wtg/Shuttle-Tracker-Node/CAD/Case/STL for print/case_6.stl

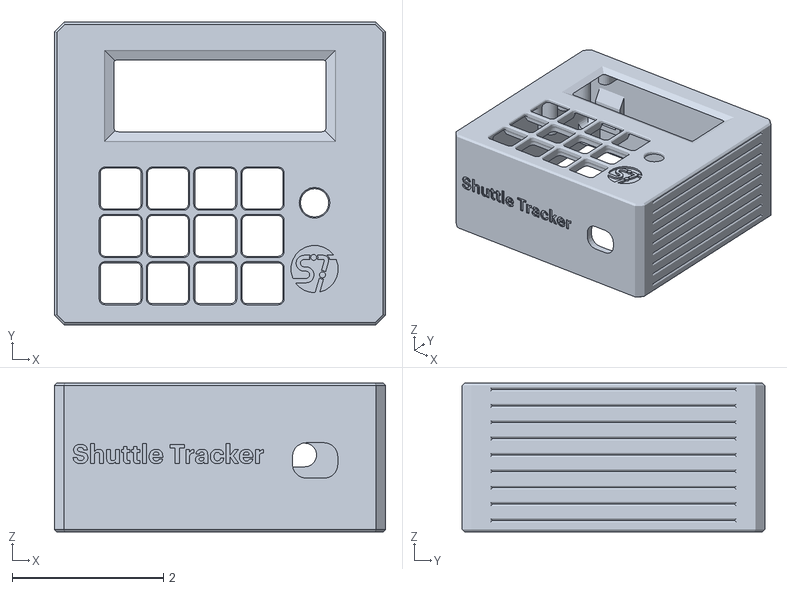
[picture p3: CAD file, 2023-11-10]
CAD/Case/STL for print/case_6.stl
4.38 x 4.00 x 1.97
