wtg/Shuttle-Tracker-Node/CAD/PCB/Footprints, Models, & Symbols/PEC11R-4215F-S0024/PEC11R-4215F-S0024.step

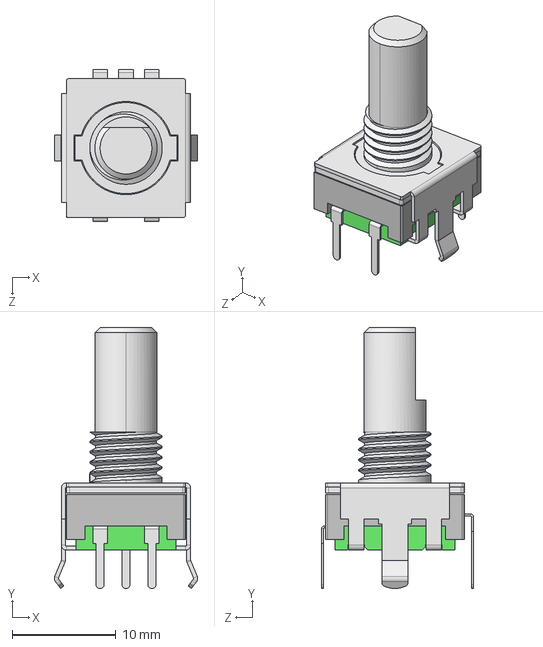
[picture p4: CAD file, 2023-01-28]
CAD/PCB/Footprints, Models, & Symbols/PEC11R-4215F-S0024/PEC11R-4215F-S0024.step
13.9 x 25.2 x 14.7 mm
