wtg/Shuttle-Tracker-Node/CAD/PCB/Shuttle Tracker Node.step

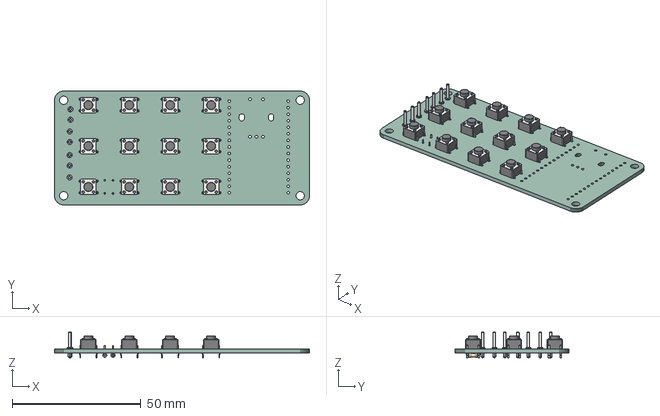
[picture p5: CAD file, 2023-02-28]
CAD/PCB/Shuttle Tracker Node.step
98.9 x 44.1 x 10.0 mm
PCB
