wtg/Shuttle-Tracker-Node/CAD/Case/EC11B-Vert-15F-green.step

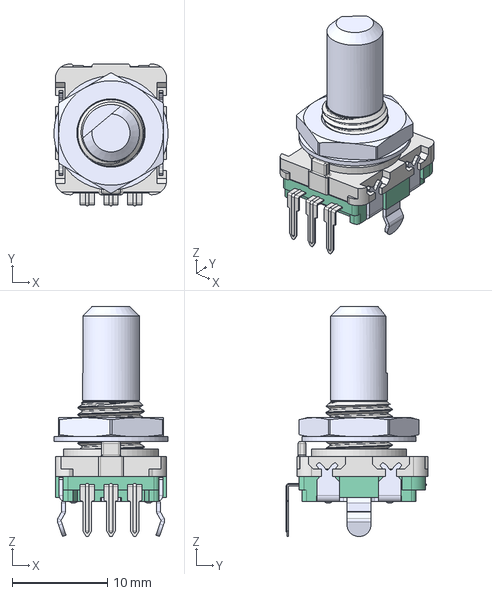
[picture p6: CAD file, 2023-02-28]
CAD/Case/EC11B-Vert-15F-green.step
12.0 x 14.9 x 24.2 mm
