wtg/Shuttle-Tracker-Node/CAD/Case/91294A128_Black-Oxide Alloy Steel Hex Drive Flat Head Screw.STEP

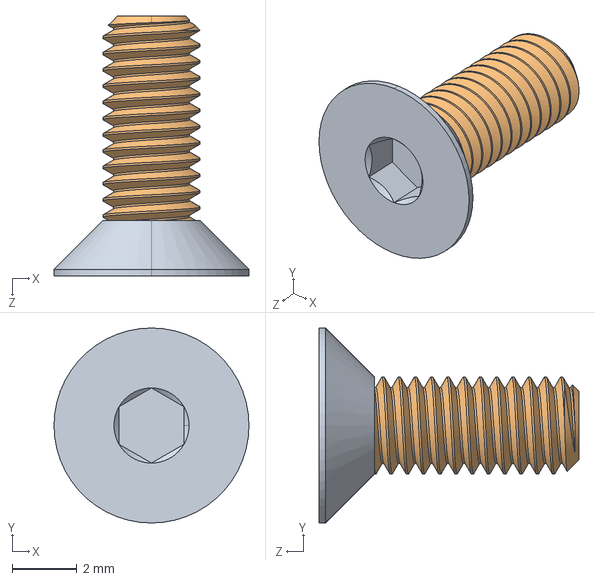
[picture p7: CAD file, 2023-03-14]
CAD/Case/91294A128_Black-Oxide Alloy Steel Hex Drive Flat Head Screw.STEP
6.00 x 6.00 x 8.00 mm
