wtg/Shuttle-Tracker-Node/CAD/Case/Old Models/encoder.STEP

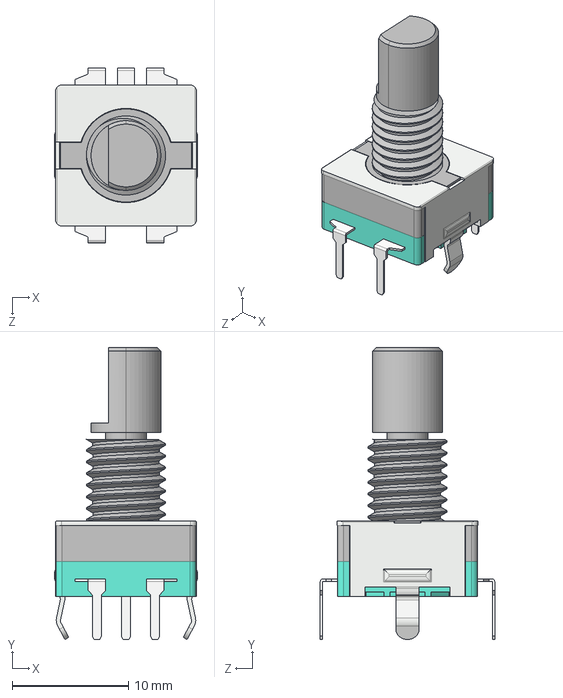
[picture p8: CAD file, 2023-02-07, an earlier design]
CAD/Case/Old Models/encoder.STEP
12.3 x 25.1 x 15.0 mm
