wtg/Shuttle-Tracker-Node/CAD/Case/Old Models/Omron 12x12 button.stp

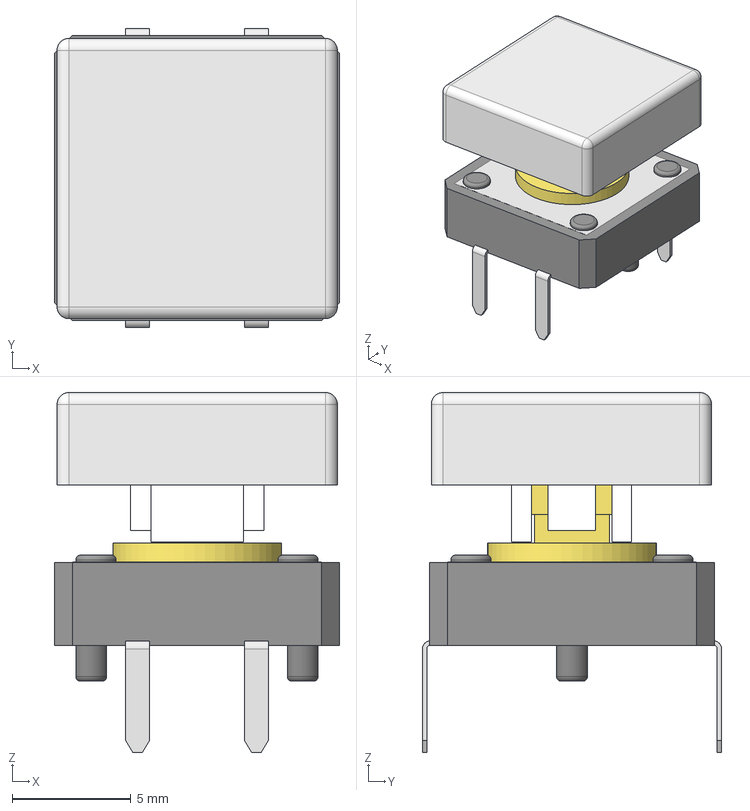
[picture p9: CAD file, 2023-02-07, an earlier design]
CAD/Case/Old Models/Omron 12x12 button.stp
12.0 x 12.6 x 15.2 mm
Buton-1212_capac-intermediar
Buton-1212_capac
Buton-1212_Baza
