wtg/Shuttle-Tracker-Node/(list of files, cad)

Other CAD files:
CAD/Case/STL for print/case_final_no_logo.stl
CAD/Case/STL for print/case_final_with_logo.stl
CAD/Case/16pin_header__.prt
CAD/Case/B3F-switch-projected.prt
CAD/Case/BF32-1010.prt
CAD/Case/NONE131.prt
CAD/Case/NONE194.prt
CAD/Case/NONE44.prt
CAD/Case/Old Models/AMS1173.3V.prt
CAD/Case/Old Models/AMS1173.3V311007.prt
CAD/Case/Old Models/B3F-switch-projected.prt
CAD/Case/Old Models/B3F-switch.prt
CAD/Case/Old Models/Buton-1212_Baza.prt
CAD/Case/Old Models/Buton-1212_capac-intermediar.prt
CAD/Case/Old Models/Buton-1212_capac.prt
CAD/Case/Old Models/Cap_0603.prt
CAD/Case/Old Models/Cap_0603311019.prt
CAD/Case/Old Models/Cap_Tam_106.prt
CAD/Case/Old Models/Cap_Tam_106311011.prt
CAD/Case/Old Models/Cap_Tam_106C.prt
CAD/Case/Old Models/Cap_Tam_106C311012.prt
CAD/Case/Old Models/Diodo_K24.prt
CAD/Case/Old Models/Diodo_K24311010.prt
CAD/Case/Old Models/LCD.prt
CAD/Case/Old Models/Led_red_0603.prt
CAD/Case/Old Models/Led_red_0603311014.prt
CAD/Case/Old Models/MicroUSB.prt
CAD/Case/Old Models/MicroUSB311005.prt
CAD/Case/Old Models/Push_Bottom.prt
CAD/Case/Old Models/Push_Bottom311009.prt
CAD/Case/Old Models/Res_102.prt
CAD/Case/Old Models/Res_102311015.prt
CAD/Case/Old Models/Res_123.prt
CAD/Case/Old Models/Res_123311017.prt
CAD/Case/Old Models/Res_471.prt
CAD/Case/Old Models/Res_471311016.prt
CAD/Case/Old Models/Res_512.prt
CAD/Case/Old Models/Res_512311018.prt
CAD/Case/Old Models/Transistor_smd.prt
CAD/Case/Old Models/Transistor_smd311013.prt
CAD/Case/Old Models/b3f-button-large.prt
CAD/Case/Old Models/bar.prt
CAD/Case/Old Models/case-print-1.prt
CAD/Case/Old Models/clamp_idea_1.prt
CAD/Case/Old Models/cp2102.prt
CAD/Case/Old Models/cp2102311008.prt
CAD/Case/Old Models/dial_1.prt
CAD/Case/Old Models/encoder.prt
CAD/Case/Old Models/esp32311006.prt
CAD/Case/Old Models/keycap_2_clip.prt
CAD/Case/Old Models/keycap_2_glue.prt
CAD/Case/Old Models/layout.prt
CAD/Case/Old Models/presentation_bla.prt
CAD/Case/PCB10213.prt
CAD/Case/Pin_D1.0mm_L10.0mm.prt
CAD/Case/Pin_D1.0mm_L10.0mm116.prt
CAD/Case/backlight.prt
CAD/Case/battery-holder.prt
CAD/Case/button_TPU_0.prt
CAD/Case/button_TPU_1.prt
CAD/Case/button_TPU_2.prt
CAD/Case/button_TPU_3.prt
CAD/Case/button_TPU_4.prt
CAD/Case/button_TPU_5.prt
CAD/Case/button_TPU_6.prt
CAD/Case/button_TPU_7.prt
CAD/Case/button_TPU_8.prt
CAD/Case/button_TPU_9.prt
CAD/Case/button_TPU_astrix.prt
CAD/Case/button_TPU_pound.prt
CAD/Case/button_cap_offset/buttonCap0.prt
CAD/Case/button_cap_offset/buttonCap1.prt
CAD/Case/button_cap_offset/buttonCap2.prt
CAD/Case/button_cap_offset/buttonCap3.prt
CAD/Case/button_cap_offset/buttonCap4.prt
CAD/Case/button_cap_offset/buttonCap5.prt
CAD/Case/button_cap_offset/buttonCap6.prt
CAD/Case/button_cap_offset/buttonCap7.prt
CAD/Case/button_cap_offset/buttonCap8.prt
CAD/Case/button_cap_offset/buttonCap9.prt
CAD/Case/button_cap_offset/buttonCapAstrix.prt
CAD/Case/button_cap_offset/buttonCapPound.prt
CAD/Case/case_2.prt
CAD/Case/case_2_back.prt
CAD/Case/case_3.prt
CAD/Case/case_3_back.prt
CAD/Case/case_4.prt
CAD/Case/case_5.prt
CAD/Case/case_5_b.prt
CAD/Case/conductor.prt
CAD/Case/dial_2.prt
CAD/Case/keys.prt
CAD/Case/lcd window.prt
CAD/Case/lcm.prt
CAD/Case/liquid crystal grabcad.prt
CAD/Case/logo.prt
CAD/Case/m3_8_screw.prt
CAD/Case/pcb_board.prt
CAD/Case/pcbboard.prt
CAD/Case/power_button.prt
CAD/Case/protoboard.prt
CAD/Case/rotary_encoder.prt
CAD/Case/smt_resistor101.prt
CAD/Case/smt_resistor222.prt
CAD/PCB/PCB.prt
CAD/PCB/Shuttle Tracker Node.prt
CAD/PCB/case_3_perfboard.prt
