wtg/Shuttle-Tracker-Node/Wiring Diagram.png

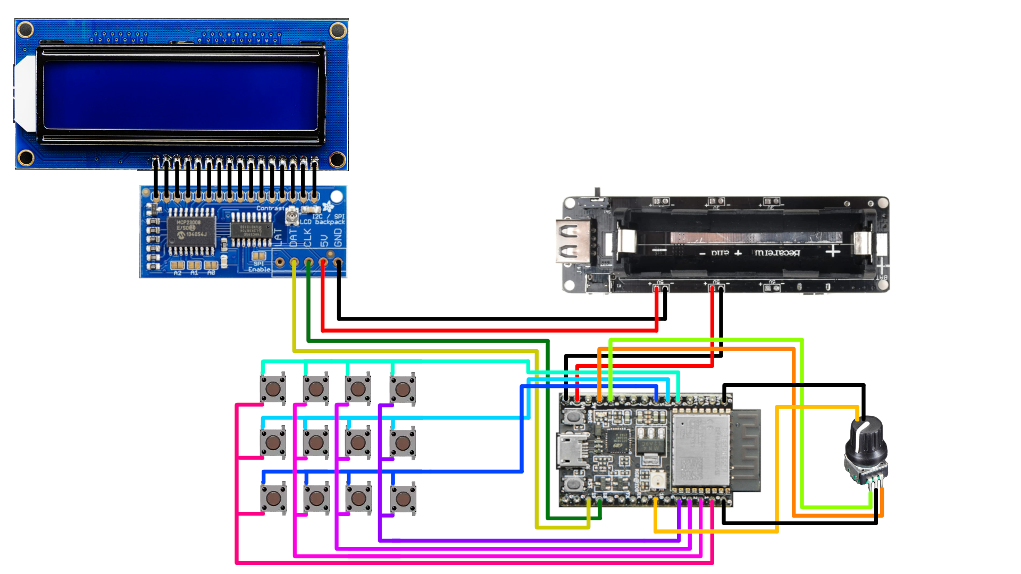
Wiring Diagram.png
