wtg/Shuttle-Tracker-Node/CAD/PCB/Shuttle Tracker Node.kicad_pcb

## KiCad design CAD/PCB/Shuttle Tracker Node.kicad_pcb (2023-03-26)

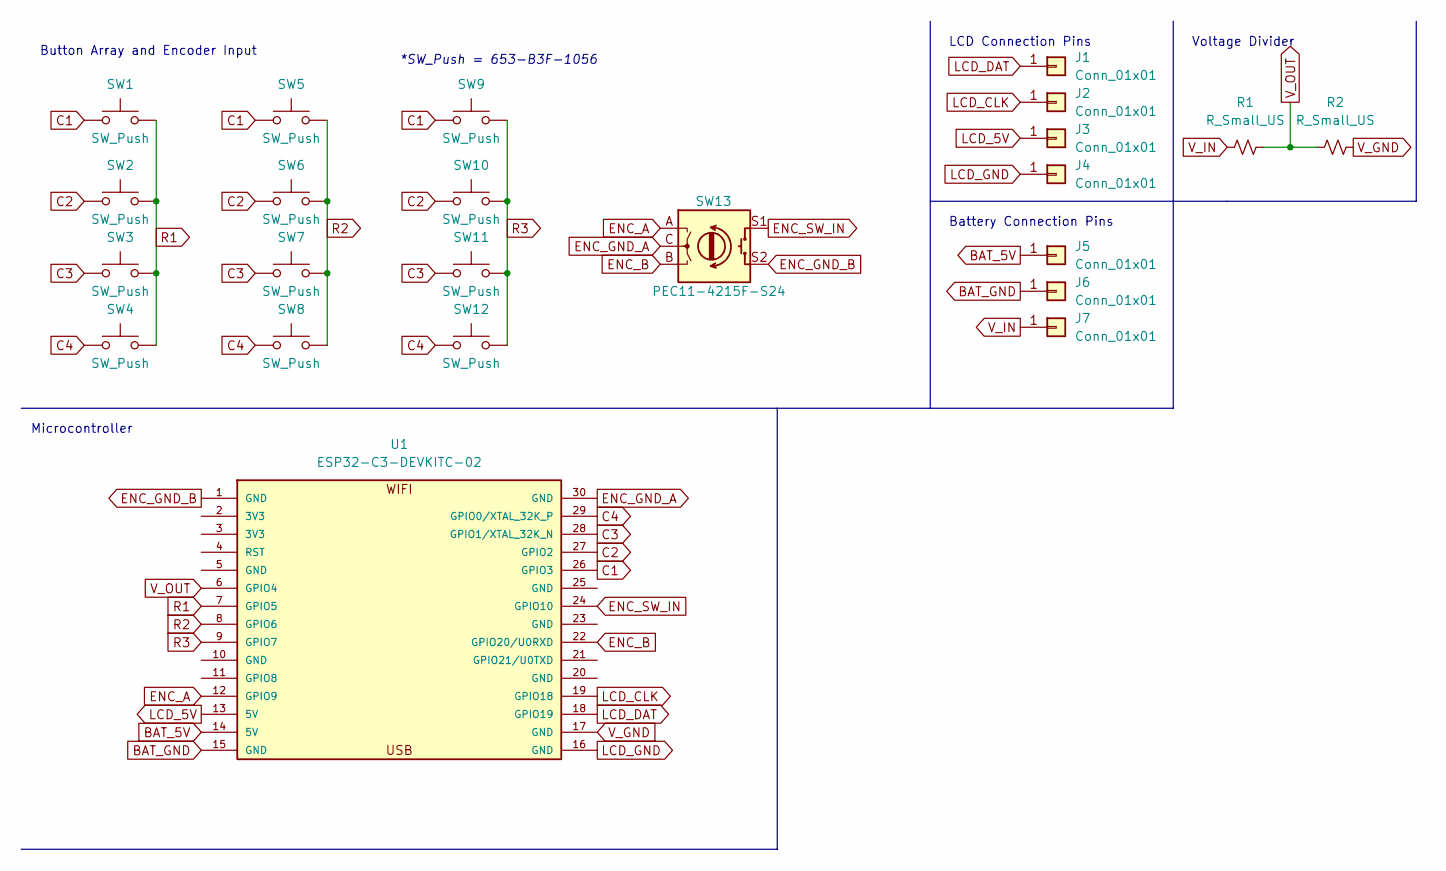
[picture p11: schematic Shuttle Tracker Node.kicad_sch]

Parts:
J1, J2, J3, J4, J5, J6, J7: Conn_01x01; Pin_D1.0mm_L10.0mm
R1, R2: R_Small_US; R_Axial_DIN0204_L3.6mm_D1.6mm_P5.08mm_Horizontal
SW1, SW2, SW3, SW4, SW5, SW6, SW7, SW8, SW9, SW10, SW11, SW12: SW_Push; B3F-1056
SW13: PEC11-4215F-S24; PEC11R-4215F-S0024
U1: ESP32-C3-DEVKITC-02; XCVR_ESP32-C3-DEVKITC-02

Connections:
BAT_5V: J5.1, U1.14 (5V)
BAT_GND: J6.1, U1.15 (GND)
C1: SW1.1, SW5.1, SW9.1, U1.26 (GPIO3)
C2: SW2.1, SW6.1, SW10.1, U1.27 (GPIO2)
C3: SW3.1, SW7.1, SW11.1, U1.28 (GPIO1/XTAL_32K_N)
C4: SW4.1, SW8.1, SW12.1, U1.29 (GPIO0/XTAL_32K_P)
ENC_A: SW13.A, U1.12 (GPIO9)
ENC_B: SW13.B, U1.22 (GPIO20/U0RXD)
ENC_GND_A: SW13.C, U1.30 (GND)
ENC_GND_B: SW13.S2, U1.1 (GND)
ENC_SW_IN: SW13.S1, U1.24 (GPIO10)
LCD_5V: J3.1, U1.13 (5V)
LCD_CLK: J2.1, U1.19 (GPIO18)
LCD_DAT: J1.1, U1.18 (GPIO19)
LCD_GND: J4.1, U1.16 (GND)
R1: SW1.2, SW2.2, SW3.2, SW4.2, U1.7 (GPIO5)
R2: SW5.2, SW6.2, SW7.2, SW8.2, U1.8 (GPIO6)
R3: SW9.2, SW10.2, SW11.2, SW12.2, U1.9 (GPIO7)
V_GND: R2.2, U1.17 (GND)
V_IN: J7.1, R1.1
V_OUT: R1.2, R2.1, U1.6 (GPIO4)

Notes on the sheet:
Microcontroller
*SW_Push = 653-B3F-1056
Voltage Divider
Button Array and Encoder Input
Battery Connection Pins
LCD Connection Pins

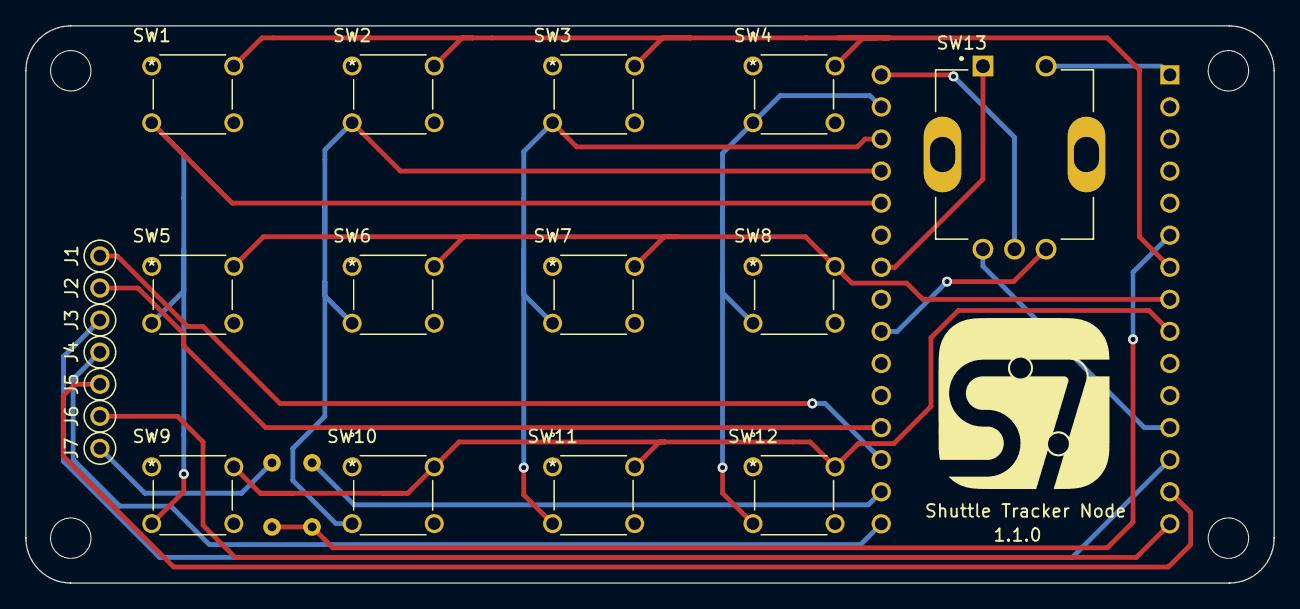
[picture p12: board Shuttle Tracker Node.kicad_pcb from above]

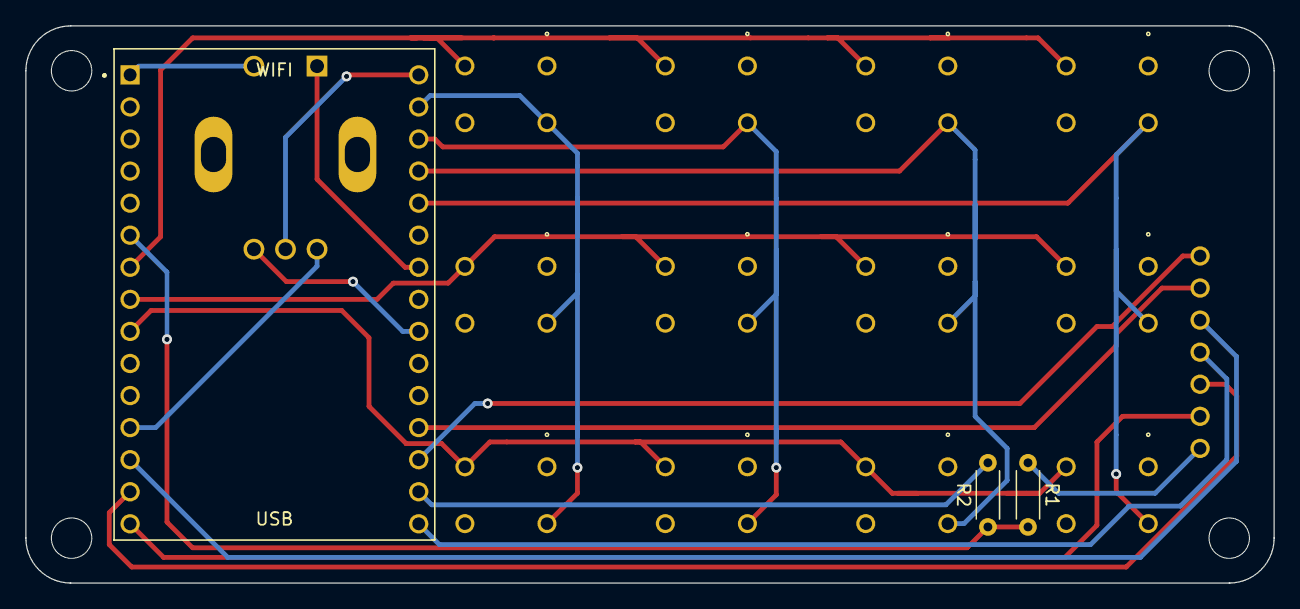
[picture p13: board Shuttle Tracker Node.kicad_pcb from below]

Board: 2 copper layers, 98.9 x 44.1 mm, 23 parts (3 on the bottom side), 21 nets.
