wtg/Shuttle-Tracker-Node/prototyping/Encoder/Encoder.ino

  /*
  This is a mockup of how we can use the encoder to control our display interface
  with the global encoderValue variable. Clockwise turns increase, while Counter
  Clockwise turns decrease encoderValue. At the moment, the amount by which the
  variable changes for each indexed turn on the encoder is not consistent. It will
  change by anywhere from 1 to 4 for each indexed rotation.
  */

  int buttonPin=6;
  int encoderPin1 = 4;
  int encoderPin2 = 5;

  volatile int lastEncoded = 0;
  volatile long encoderValue = 0;
  volatile int lastButton = 0;
  volatile long buttonValue = 0;
  volatile int buttonHeld = 0;

  int lastMSB = 0;
  int lastLSB = 0;

  const int debounce_interval = 200;

  void IRAM_ATTR updateEncoder(){
    int MSB = digitalRead(encoderPin1); //MSB = most significant bit
    int LSB = digitalRead(encoderPin2); //LSB = least significant bit

    static unsigned long last_encoder_time = 0;
    unsigned long interrupt_time = millis();
    if (interrupt_time - last_interrupt_time < debounce_interval ){return;}
    last_encoder_time = interrupt_time;
    int encoded = (MSB << 1) | LSB; //converting the 2 pin value to single number
    int sum  = (lastEncoded << 2) | encoded; //adding it to the previous encoded value


    // Overcounting issue might be solved by adjusting these if statements.
    // It might be that not all clauses are necessary
    if(sum == 0b1101 || sum == 0b0100 || sum == 0b0010 || sum == 0b1011) {
      encoderValue ++;
    }
    if(sum == 0b1110 || sum == 0b0111 || sum == 0b0001 || sum == 0b1000) {
      encoderValue --;
    }

    lastEncoded = encoded; //store this value for next time
  }

  void IRAM_ATTR updateButton(){
    static unsigned long last_interrupt_time = 0;
    unsigned long interrupt_time = millis();

    if (interrupt_time - last_interrupt_time > debounce_interval ){
      int cvalue = digitalRead(buttonPin);
      if(cvalue != lastButton){
        buttonValue++;
        lastButton = cvalue;
        last_interrupt_time = interrupt_time;
      }
    }
  }

  void setup() {

    Serial.begin(115200);
    pinMode(encoderPin1, INPUT_PULLUP);
    pinMode(encoderPin2, INPUT_PULLUP);
    attachInterrupt(encoderPin1, updateEncoder, CHANGE);
    attachInterrupt(encoderPin2, updateEncoder, CHANGE);

    pinMode(buttonPin, INPUT_PULLUP);
    pinMode(7, INPUT_PULLDOWN);
    attachInterrupt(digitalPinToInterrupt(buttonPin), updateButton, CHANGE);

  }

  void loop() {
    Serial.println("------------------");
    Serial.println(encoderValue);
    Serial.println(buttonValue);

    delay(1000);
  }
