wtg/Shuttle-Tracker-Node/prototyping/Display/Display(Adafruit)/Display (Adafruit).ino

#include <Wire.h>
#include <Adafruit_RGBLCDShield.h>
#include <utility/Adafruit_MCP23017.h>

Adafruit_RGBLCDShield lcd = Adafruit_RGBLCDShield();

void setup() {
  // Debugging output
  Serial.begin(9600);
  // set up the LCD's number of columns and rows: 
  lcd.begin(16, 2);

  int time = millis();
  lcd.print("ESP 32");
  time = millis() - time;
  Serial.print("Took "); Serial.print(time); Serial.println(" ms");
  lcd.setBacklight(WHITE);
}

uint8_t i=0;
void loop() {
  // set the cursor to column 0, line 1
  // (note: line 1 is the second row, since counting begins with 0):
  lcd.setCursor(0, 1);
  // print the number of seconds since reset:
  lcd.print(millis()/1000);

  uint8_t buttons = lcd.readButtons();

  if (buttons) {
    lcd.clear();
    lcd.setCursor(0,0);
    if (buttons & BUTTON_UP) {
      lcd.print("UP ");
      lcd.setBacklight(ON);
    }
    if (buttons & BUTTON_DOWN) {
      lcd.print("DOWN ");
      lcd.setBacklight(OFF);
    }
    if (buttons & BUTTON_RIGHT) {
      lcd.print("RIGHT ");
      lcd.setBacklight(ON);
    }
    if (buttons & BUTTON_LEFT) {
      lcd.print("LEFT ");
      lcd.setBacklight(ON);
    }    
}
