wtg/Shuttle-Tracker-Node/prototyping/Firmware_Update(Sketch).ino

#include <WiFi.h>
#include <ESPmDNS.h>
#include <WiFiUdp.h>
#include <ArduinoOTA.h>
#include "Adafruit_LiquidCrystal.h"
#include "BLEDevice.h"
#include "BLEUtils.h"
#include "BLEServer.h"
#include "BLEBeacon.h"

Adafruit_LiquidCrystal lcd(0x20);
BLEAdvertising *pAdvertising;

/*
#This section needs to be moidfied#
const char* ssid = "SpectrumSetup-50";
const char* password = "..........";
*/

void setup() {
  Serial.begin(115200);
  Serial.println("Booting");
  WiFi.mode(WIFI_STA);
  WiFi.begin(ssid, password);
  while (WiFi.waitForConnectResult() != WL_CONNECTED) {
    Serial.println("Connection Failed! Rebooting...");
    delay(5000);
    ESP.restart();
  }

  ArduinoOTA
    .onStart([]() {
      String type;
      if (ArduinoOTA.getCommand() == U_FLASH)
        type = "sketch";
      else // U_SPIFFS
        type = "filesystem";

      // NOTE: if updating SPIFFS this would be the place to unmount SPIFFS using SPIFFS.end()
      Serial.println("Start updating " + type);
    })
    .onEnd([]() {
      Serial.println("\nEnd");
    })
    .onProgress([](unsigned int progress, unsigned int total) {
      Serial.printf("Progress: %u%%\r", (progress / (total / 100)));
    })
    .onError([](ota_error_t error) {
      Serial.printf("Error[%u]: ", error);
      if (error == OTA_AUTH_ERROR) Serial.println("Auth Failed");
      else if (error == OTA_BEGIN_ERROR) Serial.println("Begin Failed");
      else if (error == OTA_CONNECT_ERROR) Serial.println("Connect Failed");
      else if (error == OTA_RECEIVE_ERROR) Serial.println("Receive Failed");
      else if (error == OTA_END_ERROR) Serial.println("End Failed");
    });

  ArduinoOTA.begin();
  
  BLEDevice::init("iBeacon");
  pAdvertising = BLEDevice::getAdvertising();
  
  Serial.println("Ready");
  Serial.print("IP address: ");
  Serial.println(WiFi.localIP());
  
  Serial.begin(115200);

  Wire.begin(4, 5);
  if (!lcd.begin(16, 2)) {
    Serial.println("Could not init backpack. Check wiring.");
    while(1);
  }
  lcd.print("Bus ID #452");

  BLEDevice::init("iBeacon");
  pAdvertising = BLEDevice::getAdvertising();
  BLEDevice::startAdvertising();
  BLEBeacon oBeacon = BLEBeacon();
  oBeacon.setManufacturerId(0x4C00); // fake Apple 0x004C LSB (ENDIAN_CHANGE_U16!)
  oBeacon.setProximityUUID(BLEUUID("9C3F95DC-7A90-4C5E-84CB-3D406D87B73B"));
  oBeacon.setMajor(452);
  oBeacon.setMinor(0);
  BLEAdvertisementData oAdvertisementData = BLEAdvertisementData();
  BLEAdvertisementData oScanResponseData = BLEAdvertisementData();
  oAdvertisementData.setFlags(0x04); // BR_EDR_NOT_SUPPORTED 0x04
  std::string strServiceData = "";
  strServiceData += (char)26;     // Len
  strServiceData += (char)0xFF;   // Type
  strServiceData += oBeacon.getData();
  oAdvertisementData.addData(strServiceData);
  pAdvertising->setAdvertisementData(oAdvertisementData);
  pAdvertising->setScanResponseData(oScanResponseData);

  lcd.setBacklight(LOW);
}

void loop() {
  ArduinoOTA.handle();
  
  pAdvertising->start();
  delay(100);
  pAdvertising->stop();
  delay(10000);
}
