wtg/Shuttle-Tracker-Node/prototyping/Keypad/Keypad + Display (Adafruit).ino

#include <Keypad.h>
#include <Wire.h>
#include <Adafruit_GFX.h>
#include <Adafruit_SSD1306.h>

#define SCREEN_WIDTH 128 // OLED display width, in pixels
#define SCREEN_HEIGHT 32 // OLED display height, in pixels

// Declaration for an SSD1306 display connected to I2C (SDA, SCL pins)
#define ROW_NUM     4 // four rows
#define COLUMN_NUM  3 // three columns

char keys[ROW_NUM][COLUMN_NUM] = {
  {'1', '2', '3'},
  {'4', '5', '6'},
  {'7', '8', '9'},
  {'*', '0', '#'}
};

byte pin_rows[ROW_NUM] = {18,5 ,17 ,16 }; // GIOP18, GIOP5, GIOP17, GIOP16 connect to the row pins
byte pin_column[COLUMN_NUM] = {4, 0, 2};  // GIOP4, GIOP0, GIOP2 connect to the column pins

Keypad keypad = Keypad( makeKeymap(keys), pin_rows, pin_column, ROW_NUM, COLUMN_NUM );
Adafruit_SSD1306 display(SCREEN_WIDTH, SCREEN_HEIGHT, &Wire, -1);

void setup() {
  Serial.begin(115200);
    if(!display.begin(SSD1306_SWITCHCAPVCC, 0x3C)) { // Address 0x3D for 128x64
    Serial.println(F("SSD1306 allocation failed"));
    for(;;);
  }
  delay(2000);
  display.clearDisplay();

  display.setTextSize(2);
  display.setTextColor(WHITE);
  display.setCursor(10, 10);
  // Display static text
  display.println("RPI");
  display.display(); 
}

void loop() {
  char key = keypad.getKey();
  if (key) {
    if(key=='#'){
    display.clearDisplay();
    display.setCursor(10,10); 
    display.print("BUS:");
    display.display();
    }
    else{
    Serial.println(key);
    display.print(key);
    display.display();
    delay(100);
    }
}
}
