wtg/Shuttle-Tracker-Node/firmware/Battery.h

#pragma once

class Battery {

	// IO Pin Assignment
	const int batteryPin = 4;

  // Number of readings for smoothing
  #define N_READINGS 10

	// Frequency to measure battery voltage in ms
	const int pollFrequency = 10000;
	unsigned long lastReadingTime = 0;

	// Resistor values for voltage divider
	const int R1 = 51000;// R1 between battery and ESP
	const int R2 = 51000;// R2 between ESP and ground

	// Battery Parameters
	const float batteryMax = 4.2;// Full charge voltage
	const float batteryMin = 3.4;// Full discharge voltage
  const float calibrationFactor = 1.0; // Add a calibration factor

  float readings[N_READINGS];  // Array to hold last N readings
  int readIndex = 0;  // Index for the current reading
	float total = 0;  // Total of the last N readings
	float averageVoltage = 0;  // The average of the last N readings

	// Battery State
	int percentage = 0;
	int lastPercentage = 0;

	// Private constructor for singleton
	Battery();

  void alertError(); // For error handling

public:
	// Get the single instance
	static Battery& get_instance();

	// Called from the main loop function
	void loop();

	// Get battery percentage
	int getPercentage() const;

private:
	// Take a reading and calculate percentage
	void measure();
};
