wtg/Shuttle-Tracker-Node/firmware/sim800l+GPS/2g+GPS+mobile.ino

#include <TinyGPS++.h>

const String PHONE = "+PHONE"; // input phone number (Dont want to show my number here)

#define rxPin 4
#define txPin 2
HardwareSerial sim800(1);

#define RXD2 16
#define TXD2 17
HardwareSerial neogps(2);

TinyGPSPlus gps;

String smsStatus,senderNumber,receivedDate,msg;
boolean isReply = false;

void setup() {
  
  Serial.begin(115200);
  Serial.println("esp32 serial initialize");
  
  sim800.begin(9600, SERIAL_8N1, rxPin, txPin);
  Serial.println("SIM800L serial initialize");

  neogps.begin(9600, SERIAL_8N1, RXD2, TXD2);
  Serial.println("neogps serial initialize");
  
  smsStatus = "";
  senderNumber="";
  receivedDate="";
  msg="";

  sim800.println("AT+CMGF=1"); //SMS text mode
  delay(1000);
  sim800.println("AT+CMGD=1,4"); //delete all saved SMS
  delay(1000);
}

void loop() {
  while(sim800.available()){
    parseData(sim800.readString());
  }

  while(Serial.available())  {
    sim800.println(Serial.readString());
  }
} 

void parseData(String buff){
  Serial.println(buff);

  unsigned int len, index;
  index = buff.indexOf("\r");
  buff.remove(0, index+2);
  buff.trim();
  if(buff != "OK"){
    index = buff.indexOf(":");
    String cmd = buff.substring(0, index);
    cmd.trim();
    
    buff.remove(0, index+2);    
    if(cmd == "+CMTI"){

      index = buff.indexOf(",");
      String temp = buff.substring(index+1, buff.length()); 
      temp = "AT+CMGR=" + temp + "\r"; 
      sim800.println(temp); 
    }
    else if(cmd == "+CMGR"){
      extractSms(buff);
      Serial.println("Sender Number: "+senderNumber);
      Serial.println("PHONE: "+PHONE);
      if(senderNumber == PHONE){
        if(msg == "get location"){
          sendLocation();
        }
        else if(msg == "get speed"){
          sendSpeed();
        }
      }
      sim800.println("AT+CMGD=1,4"); //delete all saved SMS
      delay(1000);
      smsStatus = "";
      senderNumber="";
      receivedDate="";
      msg="";
    }
  }
  else{
  }
}
void extractSms(String buff){
   unsigned int index;
   Serial.println(buff);

    index =buff.indexOf(",");
    smsStatus = buff.substring(1, index-1); 
    buff.remove(0, index+2);
    
    senderNumber = buff.substring(0, 13);
    buff.remove(0,19);
   
    receivedDate = buff.substring(0, 20);
    buff.remove(0,buff.indexOf("\r"));
    buff.trim();
    
    index =buff.indexOf("\n\r");
    buff = buff.substring(0, index);
    buff.trim();
    msg = buff;
    buff = "";
    msg.toLowerCase();

}

void sendLocation()
{
  // Can take up to 60 seconds
  boolean newData = false;
  for (unsigned long start = millis(); millis() - start < 2000;)
  {
    while (neogps.available())
    {
      if (gps.encode(neogps.read()))
      {
        newData = true;
      }
    }
  }
  if (newData)      //If newData is true
  {
    Serial.print("Latitude= "); 
    Serial.print(gps.location.lat(), 6);
    Serial.print(" Longitude= "); 
    Serial.println(gps.location.lng(), 6);
    newData = false;
    delay(300);
    ///*
    sim800.print("AT+CMGF=1\r");
    delay(1000);
    sim800.print("AT+CMGS=\""+PHONE+"\"\r");
    delay(1000);
    sim800.print("http://maps.google.com/maps?q=loc:");
    sim800.print(gps.location.lat(), 6);
    sim800.print(",");
    sim800.print(gps.location.lng(), 6);
    delay(100);
    sim800.write(0x1A); //ascii code for ctrl-26 //sim800.println((char)26); //ascii code for ctrl-26
    delay(1000);
    Serial.println("GPS Location SMS Sent Successfully.");
    //*/
  }
}

void sendSpeed()
{
  // Can take up to 60 seconds
  boolean newData = false;
  for (unsigned long start = millis(); millis() - start < 2000;)
  {
    while (neogps.available())
    {
      if (gps.encode(neogps.read()))
      {
        newData = true;
      }
    }
  }
  if (newData)      //If newData is true
  {
    newData = false;
    Serial.print("Speed km/h= ");  
    Serial.println(gps.speed.kmph());
    delay(300);
    ///*
    sim800.print("AT+CMGF=1\r");
    delay(1000);
    sim800.print("AT+CMGS=\""+PHONE+"\"\r");
    delay(1000);
    sim800.print("Speed km/h: ");
    sim800.print(gps.speed.kmph());
    delay(100);
    sim800.write(0x1A); //ascii code for ctrl-26 //sim800.println((char)26); //ascii code for ctrl-26
    delay(1000);
    Serial.println("GPS Speed SMS Sent Successfully.");
    //*/
  }
}
