wtg/Shuttle-Tracker-Node/(commit log)

2022-10-25 Mono-chrome display code
    This code uses Adafruit_RGBLCDShield library, and it also works properly with the ESP 32 board
2022-10-25 Keypad button testing
2023-01-28 Preliminary wiring diagram
2023-01-28 Create I2C-Scanner
    This is the code to find the address of I2C device that is connected with a board.
2023-01-28 Add CAD files
    [AMS1173.3V.prt, AMS1173.3V311007.prt, B3F-switch-projected.prt, B3F-switch.prt, Buton-1212_Baza.prt, Buton-1212_capac-intermediar.prt, Buton-1212_capac.prt, Cap_0603.prt]
2023-02-02 Encoder prototypes, one ready for use(ish)
2023-02-07 Added support for encoder push button prototype
2023-02-07 Updated CAD files to current prototype
    [AMS1173.3V.prt, AMS1173.3V311007.prt, B3F-switch-projected.prt, B3F-switch.prt, BF32-1010.prt, Buton-1212_Baza.prt, Buton-1212_capac-intermediar.prt, Buton-1212_capac.prt]
2023-02-08 moved hole position to top
    [case_3.prt]
2023-02-10 Create iBeacon+Display+Power_Level
    BLE power level is modified
2023-02-10 Finished PCB Schematic
    [Shuttle Tracker Node.kicad_pcb, Shuttle Tracker Node.kicad_sch]
2023-02-10 update CAD for 2/10 meeting
    [buttonCap0.prt, buttonCap1.prt, buttonCap2.prt, buttonCap3.prt, buttonCap4.prt, buttonCap5.prt, buttonCap6.prt, buttonCap7.prt]
2023-02-11 Converted button matrix code to interrupt paradigm.
    Needs to be tested once we have dev board for button matrix
2023-02-14 Place Components on PCB
    [Shuttle Tracker Node.kicad_pcb, Shuttle Tracker Node.kicad_sch]
2023-02-14 Finished PCB Routing
    [Shuttle Tracker Node.kicad_pcb, Shuttle Tracker Node.kicad_sch]
2023-02-14 Added Silkscreen
    [Shuttle Tracker Node.kicad_pcb]
2023-02-15 fixed keypad const array from string to char
    [Keypad-Interrupt.ino]
2023-02-17 testing with buttons
2023-02-17 PCB Routing Updates
    [Shuttle Tracker Node.kicad_pcb]
2023-02-17 reorganized prototype files
2023-02-17 Updated keycap tolerances and font style
    [button_TPU_0.prt, button_TPU_1.prt, button_TPU_2.prt, button_TPU_3.prt, button_TPU_4.prt, button_TPU_5.prt, button_TPU_6.prt, button_TPU_7.prt]
2023-02-17 added power button
    [button_TPU_0.prt, case_3.prt, keys.prt, power_button.prt]
2023-02-21 Added Mounting Holes
    [Shuttle Tracker Node.kicad_pcb]
2023-02-21 Changed IO Configuration
    [Shuttle Tracker Node.kicad_pcb, Shuttle Tracker Node.kicad_sch]
2023-02-22 Changed location of mounting holes
    [Shuttle Tracker Node.kicad_pcb]
2023-02-22 Fixed side of board not being straight
    [Shuttle Tracker Node.kicad_pcb]
2023-02-22 Fixed trace and mounting hole overlap
    [Shuttle Tracker Node.kicad_pcb]
2023-02-24 Working on interrupt keypad.
    needs work on pin assignment, Currently has chaotic behavior.
2023-02-24 bouncing value updates on interrupt.
2023-02-28 Add fabrication files
    [Shuttle Tracker Node-B_Cu.gbr, Shuttle Tracker Node-B_Mask.gbr, Shuttle Tracker Node-B_Paste.gbr, Shuttle Tracker Node-B_Silkscreen.gbr, Shuttle Tracker Node-Edge_Cuts.gbr, Shuttle Tracker Node-F_Cu.gbr, Shuttle Tracker Node-F_Mask.gbr, Shuttle Tracker Node-F_Paste.gbr]
2023-02-28 Switched to a polling paradigm.
    Interrupt based keypad wasnt working. For now we should stick to polling.
2023-02-28 Initial menu navigation with encoder
2023-02-28 Added bouncing to the encoder
2023-02-28 updated backplate and reorginized PCB assembly update
    [BF32-1010.prt, EC11B-Vert-15F-green.step, NONE131.prt, NONE194.prt, NONE44.prt, PCB.prt, PCB10213.prt, Pin_D1.0mm_L10.0mm.prt]
2023-03-14 Finilzed Cad Model for PCB
    [16pin_header__.prt, 91294A128_Black-Oxide Alloy Steel Hex Drive Flat Head Screw.STEP, PCB10213.prt, backlight.prt, case_3.prt, case_3_back.prt, case_4.prt, case_5.prt]
2023-03-18 Updated pin configuration for buttons
    [Shuttle Tracker Node.kicad_pcb]
2023-03-18 Updated pin congifuration again
    [Shuttle Tracker Node.kicad_pcb]
2023-03-18 updated (hopefully) final case design
    [case_4.prt, case_5.prt, power_button.prt]
2023-03-19 Add serial command interface to emulate keypad and encoder
2023-03-19 Add battery measurement
2023-03-19 Update fabrication files
    [Shuttle Tracker Node-B_Cu.gbr, Shuttle Tracker Node-B_Mask.gbr, Shuttle Tracker Node-B_Paste.gbr, Shuttle Tracker Node-B_Silkscreen.gbr, Shuttle Tracker Node-Edge_Cuts.gbr, Shuttle Tracker Node-F_Cu.gbr, Shuttle Tracker Node-F_Mask.gbr, Shuttle Tracker Node-F_Paste.gbr]
2023-03-19 Fix cursor and change Bluetooth off message
    [Display.cpp]
2023-03-24 Updated spacing for pins
    [Shuttle Tracker Node.kicad_pcb]
2023-03-24 updated pin configuration for encoder
    [Shuttle Tracker Node.kicad_pcb]
2023-03-24 Silkscreen updates
    [Shuttle Tracker Node.kicad_pcb]
2023-03-24 Set pin assignments to match schematic, adjust resistor value
2023-03-24 Updated size of connector pads
    [Shuttle Tracker Node.kicad_pcb]
2023-03-25 Changed Logo
    [Shuttle Tracker Node.kicad_pcb]
2023-03-25 Update logo
    [Shuttle Tracker Node.kicad_pcb]
2023-03-26 Resets busID when entring new busId.
    [Display.cpp]
2023-03-26 Added new makefile option for production
    Disables unecesasry serial printing
2023-04-11 updated to latest .stl
    [case_5_no_logo.stl, case_final_no_logo.stl, case_final_with_logo.stl]
2023-09-19 adding elements for a better battery algorithm
2023-09-24 add sanity check and event driven update inside the battery loop
2023-09-24 new battery algorithm
2023-10-06 fixing battery accuracy
2023-10-07 the wifi stat from Display will print out the actual IP address
2023-10-13 Insertion of USB Update Porthole
    Constructed a hole and rearranged case layout to make it easier to update each node
2023-10-31 Fixes the ibeacon no bus ID broadcast
    Initially it was setting the major with the device mac, changed to store mac in minor. Fixed major field not updating
    [Beacon.cpp]
2023-10-31 minor visual bug fixes
    Need to fix advertising interval
    [Beacon.cpp, Beacon.h]
2023-11-10 Hole added
    [case_6.stl]
2023-11-10 G code for printing TWO cases
2024-03-22 create a new state for the navigation panel to show the current version of the node
2024-04-16 bug fixed for naming
    [Display.cpp]
2025-06-06 add SIM800L+NEO6M_GPS schematic on ESP32 and add sending/recieve function on GPS to phone device
2025-06-13 adding GPS via a server(firebase database for now) to the device
2025-06-13 fix error on defining GSM module
    [TelemetryManager.h]
